sanchopansen/Arduino-Birdsongbox/pictures/pic2.jpeg

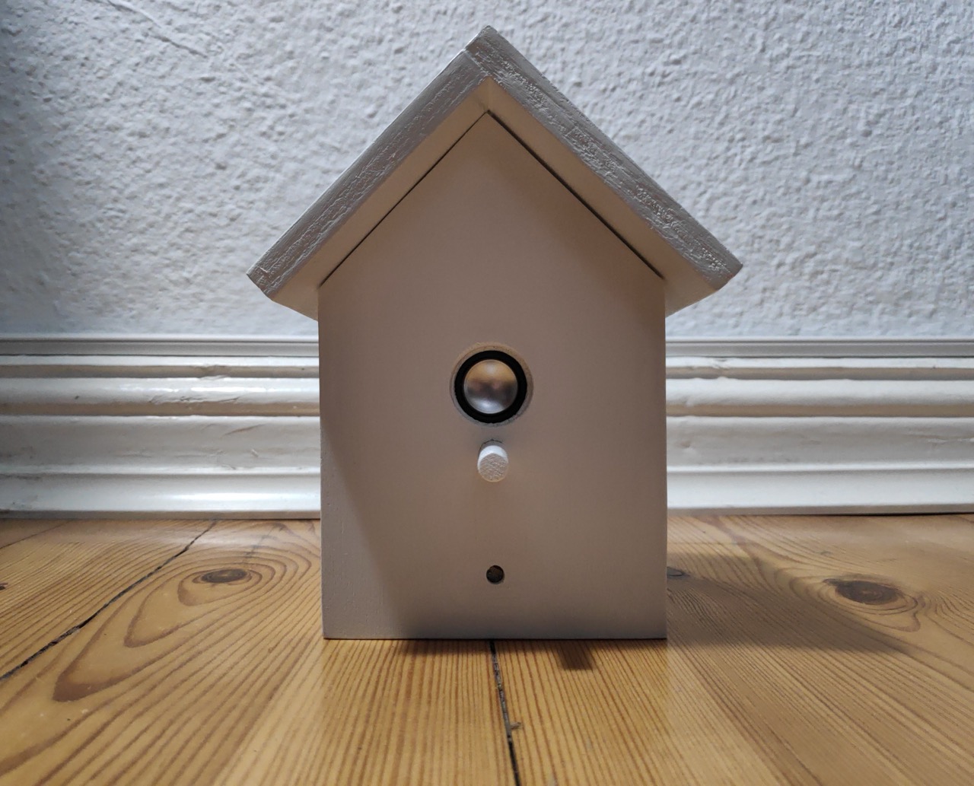
pictures/pic2.jpeg
