sanchopansen/Arduino-Birdsongbox/pictures/pic3.jpeg

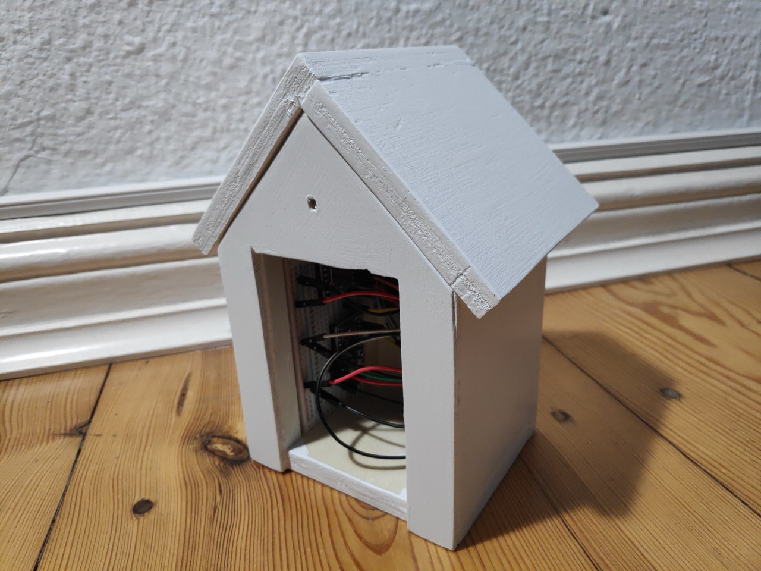
pictures/pic3.jpeg
