sanchopansen/Arduino-Birdsongbox/pictures/pic4.jpeg

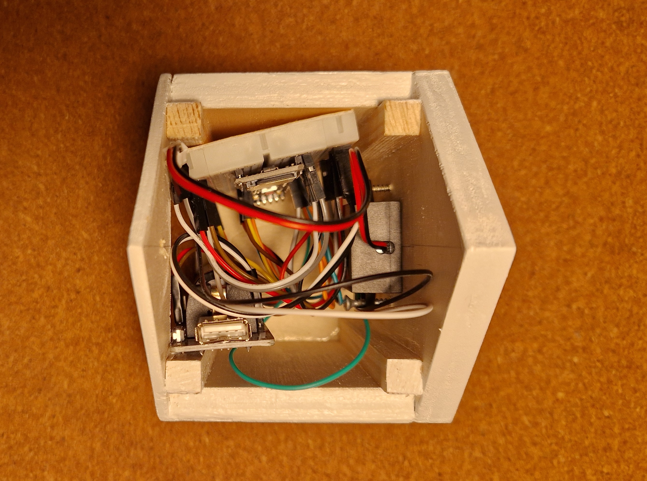
pictures/pic4.jpeg
