sanchopansen/Arduino-Birdsongbox/pictures/pic5.jpeg

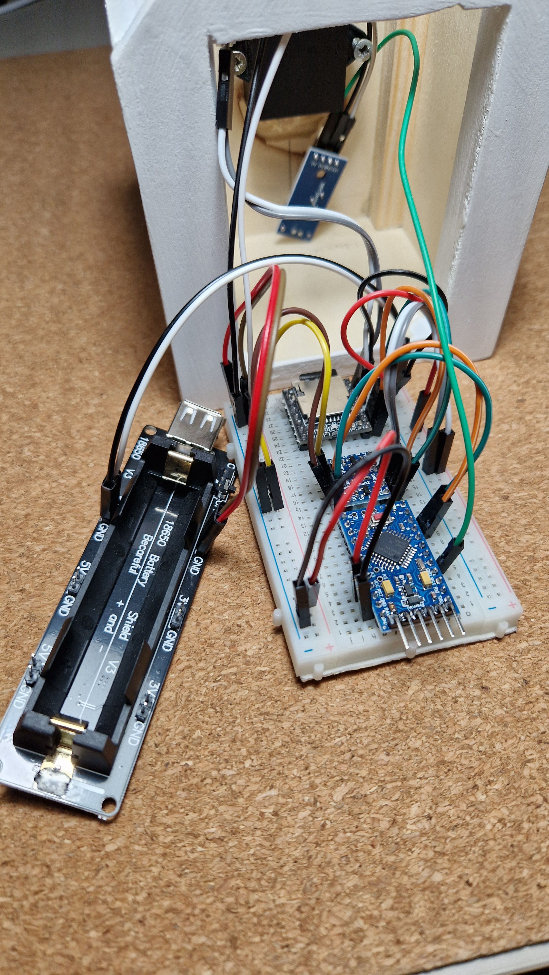
pictures/pic5.jpeg
