sanchopansen/Arduino-Birdsongbox/schematic/birdsongbox_simple_schematic.pdf

3.7V

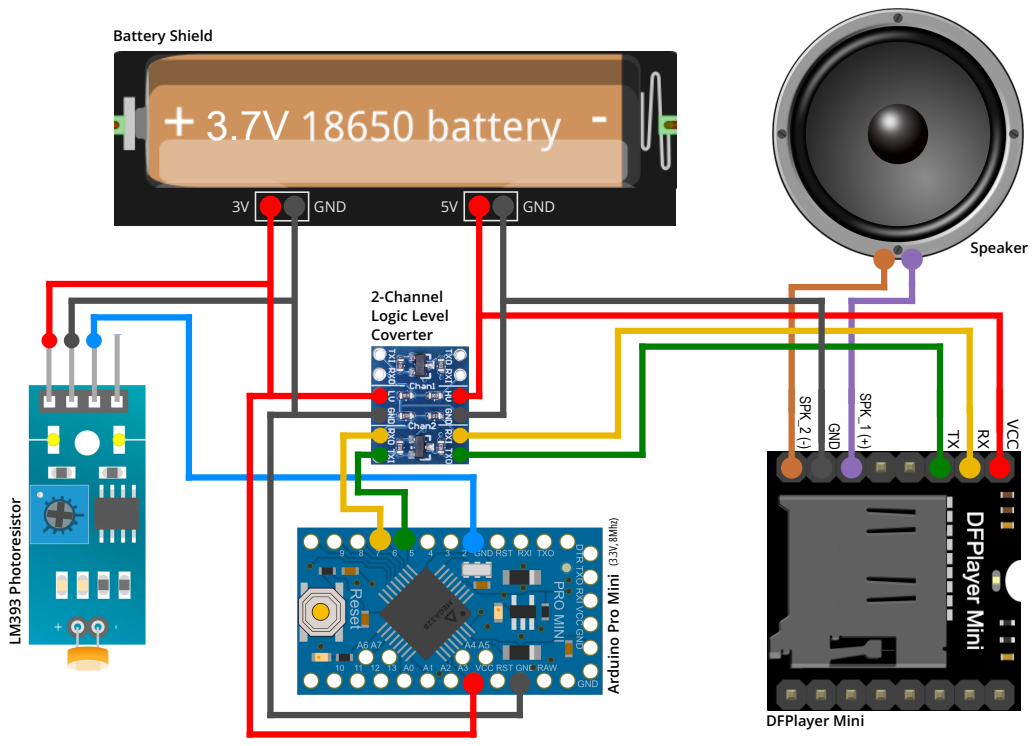
[picture p9: page 1]
Battery Shield; DFPlayer Mini; 2-Channel Logic Level Coverter; Speaker; LM393 Photoresistor; SPK_2 (-); SPK_1 (+); VCC; GND

Arduino Pro Mini (3.3V, 8Mhz)
