sanchopansen/Arduino-Birdsongbox/pictures/pic6.jpeg

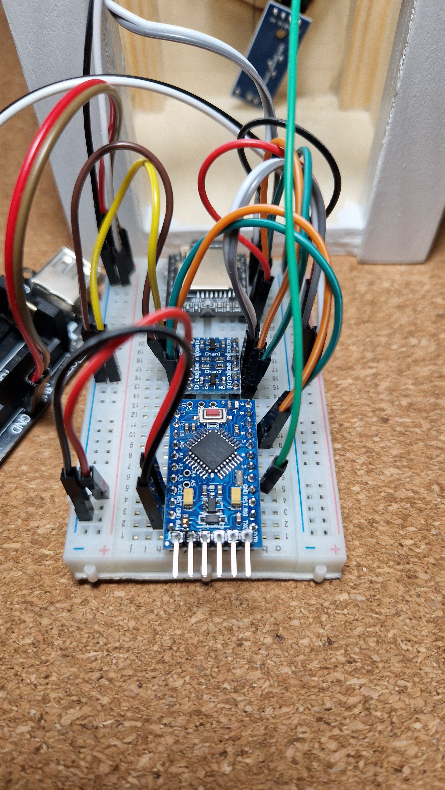
pictures/pic6.jpeg
